1800alex/atx-powered-car-stereo/schematic/car-stereo.pdf

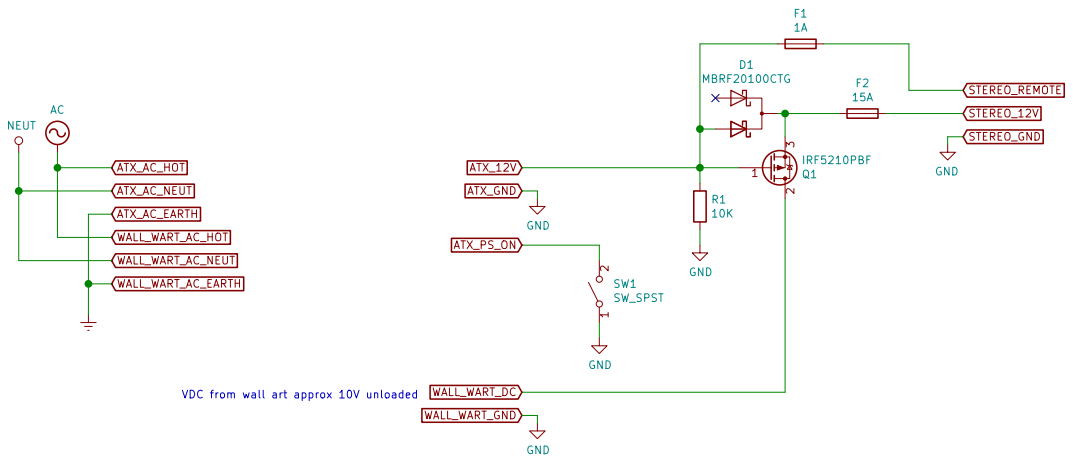
[picture p7: page 1]

VDC from wall art approx 10V unloaded

File: car-stereo.sch Sheet: /
Id: 1/1 Title: Car Stereo Power Supply
