1800alex/atx-powered-car-stereo/simulation/car-stereo-power.asc

D1: schottky; MBR20100CT
M1: pmos; IRF7210
R1: res; 10K
V1: voltage; 0
V2: voltage; 10
Named nets: 0, VOUT, CPU-12V
.dc V1 0 12 1
