1800alex/atx-powered-car-stereo/schematic/car-stereo.sch

## KiCad design schematic/car-stereo.sch (2019-06-12)

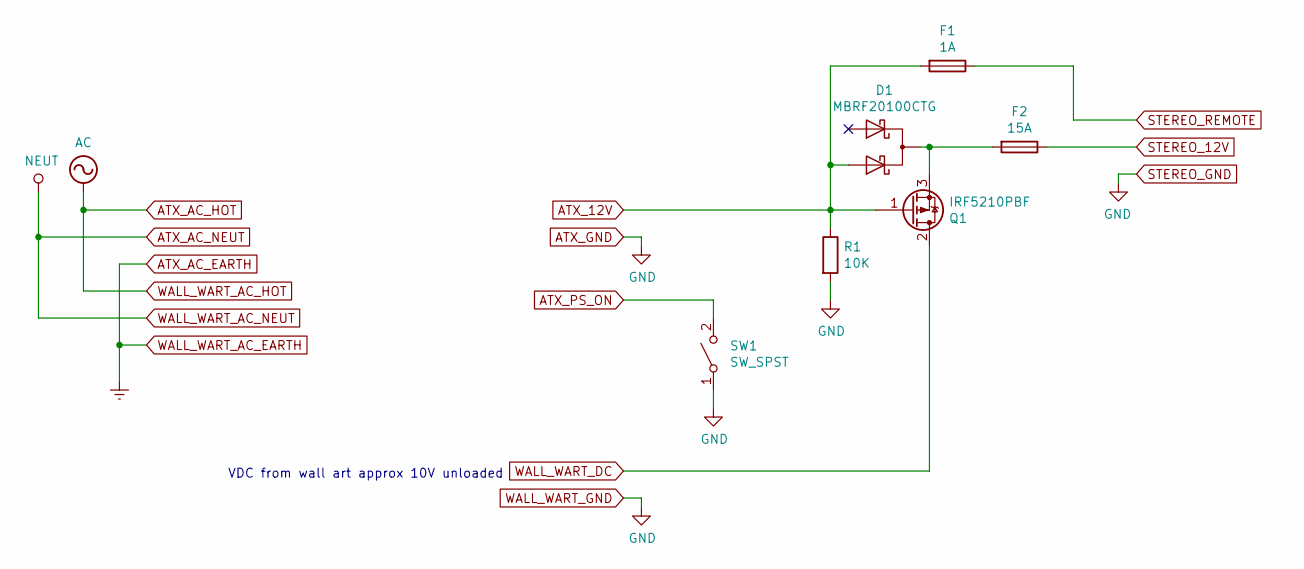
[picture p8: schematic car-stereo.sch]

Parts:
D1: MBRF20100CTG; TO-247-3_Vertical
F1: 1A
F2: 15A
Q1: ‎IRF5210PBF‎; TO-220-3_Vertical
R1: 10K
SW1: SW_SPST

Connections:
ATX_12V: D1.3 (A2), F1.2, Q1.1 (G), R1.1
ATX_GND: R1.2, SW1.1 (A)
ATX_PS_ON: SW1.2 (B)
unnamed: D1.2 (K), F2.2, Q1.3 (S)
STEREO_12V: F2.1
STEREO_REMOTE: F1.1
WALL_WART_DC: Q1.2 (D)

Notes on the sheet:
VDC from wall art approx 10V unloaded
